JohnWallis01/TTL-GPU/CPLD-GPU Kicad Schematics/CPLD-GPU.html

# E:\Libraries\Documents\TTL-GPU\CPLD-GPU Kicad Schematics\CPLD-GPU.sch

23/11/2021 10:13:46

Eeschema (5.1.10)-1

Component Count:61

Ref | Qnty | Value | Part | Footprint | Description | Vendor
C1, C2 | 2 | 32p | Device:C | Capacitor_SMD:C_0805_2012Metric | Unpolarized capacitor
C3, C4, C5, C6, C7, C8, C9, C10, C11, C12, C13, C14 | 12 | 100n | Device:C | Capacitor_SMD:C_0805_2012Metric | Unpolarized capacitor
C15, C16, C17, C18, C19, C20, C21, C22, C23, C24, C25, C26 | 12 | 1u | Device:C | Capacitor_SMD:C_0805_2012Metric | Unpolarized capacitor
J1 | 1 | DB15_Female_HighDensity_MountingHoles | Connector:DB15_Female_HighDensity_MountingHoles | Connector_Dsub:DSUB-15_Female_Horizontal_P2.77x2.84mm_EdgePinOffset4.94mm_Housed_MountingHolesOffset7.48mm | 15-pin female D-SUB connector, High density (3 columns), Triple Row, Generic, VGA-connector, Mounting Hole
J2, J3 | 2 | Conn_01x02 | Connector_Generic:Conn_01x02 | Connector_PinHeader_2.54mm:PinHeader_1x02_P2.54mm_Vertical | Generic connector, single row, 01x02, script generated (kicad-library-utils/schlib/autogen/connector/)
J5 | 1 | Conn_01x05 | Connector_Generic:Conn_01x05 | Connector_PinHeader_2.54mm:PinHeader_1x05_P2.54mm_Vertical | Generic connector, single row, 01x05, script generated (kicad-library-utils/schlib/autogen/connector/)
J6 | 1 | Conn_01x16 | Connector_Generic:Conn_01x16 | Connector_PinHeader_2.54mm:PinHeader_1x16_P2.54mm_Vertical | Generic connector, single row, 01x16, script generated (kicad-library-utils/schlib/autogen/connector/)
R1 | 1 | 2.2M | Device:R | Resistor_SMD:R_0805_2012Metric | Resistor
R2 | 1 | 1K | Device:R | Resistor_SMD:R_0805_2012Metric | Resistor
R3, R4, R5, R21, R22 | 5 | 50K | Device:R | Resistor_SMD:R_0805_2012Metric | Resistor
R6, R7, R8, R9, R10, R11, R12, R13, R14, R15, R16, R17, R18, R19, R20 | 15 | 1.5K | Device:R | Resistor_SMD:R_0805_2012Metric | Resistor
U1 | 1 | SN74LVC1GX04DCKR | Gen3Parts:SN74LVC1GX04DCKR | Package_TO_SOT_SMD:SOT-363_SC-70-6_Handsoldering | Crystal Oscillator Driver
U2, U5 | 2 | AT25DN512C-XMHF-T | Gen3Parts:AT25DN512C-XMHF-T | Package_SO:SSOP-8_2.95x2.8mm_P0.65mm | NOR Flash 512K, 2.3V, 104Mhz Serial Flash
U3 | 1 | XC9572XL-10TQG100C | Gen3Parts:XC9572XL-10TQG100C | Package_QFP:TQFP-100_14x14mm_P0.5mm | XC9572XL-10TQG100C XC9572XL-10TQG100C, CPLD XC9500XL Flash 72 Cells, 72 I/O, 4 Labs, ISP, 3 3.6 V 100-Pin TQFP
U4 | 1 | CY62136EV30LL-45ZSXI | Gen3Parts:CY62136EV30LL-45ZSXI | Package_SO:TSOP-II-44_10.16x18.41mm_P0.8mm | CYPRESS SEMICONDUCTOR - CY62136EV30LL-45ZSXI - IC, SRAM, 2 Mbit, 128K x 16bit, 45 ns Access Time, Parallel, 2.2 V to 3.6 V supply, TSOP-II-44
U6, U7 | 2 | 74LS541 | 74xx:74LS541 | Package_SO:TSSOP-20_4.4x6.5mm_P0.65mm | 8-bit Buffer/Line Driver 3-state outputs
Y1 | 1 | Crystal | Device:Crystal | Crystal:Crystal_HC49-4H_Vertical | Two pin crystal
