JohnWallis01/TTL-GPU/MAX7000-GPU Kicad Schematics/MAX7000-GPU/MAX7000-GPU.html

# E:\Libraries\Documents\TTL-GPU\MAX7000-GPU Kicad Schematics\MAX7000-GPU\MAX7000-GPU.sch

17/04/2022 12:52:48

Eeschema (5.1.10)-1

Component Count:82

Ref | Qnty | Value | Part | Footprint | Description | Vendor
C1, C2, C3, C4, C5, C6, C7, C8, C9, C10, C11, C12, C13, C14, C15, C17, C21, C23, C25 | 19 | 100n | Device:C | Capacitor_SMD:C_0805_2012Metric | Unpolarized capacitor
C16, C20, C22 | 3 | 10n | Device:C | Capacitor_SMD:C_0805_2012Metric | Unpolarized capacitor
C18, C19 | 2 | 10p | Device:C | Capacitor_SMD:C_0805_2012Metric | Unpolarized capacitor
C24 | 1 | 330n | Device:C | Capacitor_SMD:C_0805_2012Metric | Unpolarized capacitor
D1, D2, D3, D4, D5, D6, D7, D8 | 8 | LED | Device:LED | LED_SMD:LED_0805_2012Metric | Light emitting diode
J1 | 1 | Mini-DIN-6 | Connector:Mini-DIN-6 | Custom_Footprints:Connector_Mini-DIN_Female_6Pin_2rows | 6-pin Mini-DIN connector
J2, J9 | 2 | Conn_01x04_Male | Connector:Conn_01x04_Male | Connector_PinSocket_2.54mm:PinSocket_1x04_P2.54mm_Vertical | Generic connector, single row, 01x04, script generated (kicad-library-utils/schlib/autogen/connector/)
J3 | 1 | Conn_01x05 | Connector_Generic:Conn_01x05 | Connector_PinSocket_2.54mm:PinSocket_1x05_P2.54mm_Vertical | Generic connector, single row, 01x05, script generated (kicad-library-utils/schlib/autogen/connector/)
J4 | 1 | Barrel_Jack | Connector:Barrel_Jack | Connector_BarrelJack:BarrelJack_Wuerth_6941xx301002 | DC Barrel Jack
J5 | 1 | DB15_Female_HighDensity_MountingHoles | Connector:DB15_Female_HighDensity_MountingHoles | Connector_Dsub:DSUB-15-HD_Female_Horizontal_P2.29x1.98mm_EdgePinOffset3.03mm_Housed_MountingHolesOffset4.94mm | 15-pin female D-SUB connector, High density (3 columns), Triple Row, Generic, VGA-connector, Mounting Hole
J6 | 1 | Conn_01x03_Male | Connector:Conn_01x03_Male | Connector_PinSocket_2.54mm:PinSocket_1x03_P2.54mm_Vertical | Generic connector, single row, 01x03, script generated (kicad-library-utils/schlib/autogen/connector/)
J7, J8 | 2 | Conn_01x16_Male | Connector:Conn_01x16_Male | Connector_PinSocket_2.54mm:PinSocket_1x16_P2.54mm_Vertical | Generic connector, single row, 01x16, script generated (kicad-library-utils/schlib/autogen/connector/)
J10 | 1 | Conn_02x05_Odd_Even | Connector_Generic:Conn_02x05_Odd_Even | Connector_PinHeader_2.54mm:PinHeader_2x05_P2.54mm_Vertical | Generic connector, double row, 02x05, odd/even pin numbering scheme (row 1 odd numbers, row 2 even numbers), script generated (kicad-library-utils/schlib/autogen/connector/)
R1, R3, R7, R11 | 4 | 1M | Device:R | Resistor_SMD:R_0805_2012Metric | Resistor
R2, R5, R6, R9, R10, R13, R14, R15, R16, R18, R19 | 11 | 1k | Device:R | Resistor_SMD:R_0805_2012Metric | Resistor
R4, R12, R17, R20, R21, R22, R23, R24, R25 | 9 | 330 | Device:R | Resistor_SMD:R_0805_2012Metric | Resistor
R8 | 1 | 50k | Device:R | Resistor_SMD:R_0805_2012Metric | Resistor
SW1, SW2, SW3 | 3 | SW_Push | MAX7000CPU-Gen2_5-rescue:SW_Push-Switch-MAX7000CPU-Gen2-rescue | Button_Switch_THT:SW_PUSH_6mm
U1 | 1 | EPM7128s | MAX7000CPU-Gen2_5-rescue:EPM7128slc84-15n-CPU_ics | Package_LCC:PLCC-84_THT-Socket
U2 | 1 | 74HC00 | 74xx:74HC00 | Package_DIP:DIP-14_W7.62mm | quad 2-input NAND gate
U3, U5, U8 | 3 | NE555 | Timer:NE555P | Package_DIP:DIP-8_W7.62mm | Precision Timers, 555 compatible, PDIP-8
U4 | 1 | AS6C1008 | MAX7000CPU-Gen2_5-rescue:AS6C1008-55PCN-CPU_ics | Package_DIP:DIP-32_W15.24mm
U6, U7, U9 | 3 | AT24C64 | GPU_Parts:AT24C64B-10PU-2.7 | Package_DIP:DIP-8_W7.62mm | Atmel AT24C64B-10PU-2.7 EEPROM Memory, 64kbit, 0.6us, 1.8 5.5 V 8-Pin PDIP
U10 | 1 | L7805 | Regulator_Linear:L7805 | Package_TO_SOT_THT:TO-220-3_Vertical | Positive 1.5A 35V Linear Regulator, Fixed Output 5V, TO-220/TO-263/TO-252
Y1 | 1 | Crystal | Device:Crystal | Crystal:Crystal_HC49-U_Vertical | Two pin crystal
