JohnWallis01/TTL-GPU/(list of files, drawings)

Other design files:
MAX7000-GPU Kicad Schematics/MAX7000-GPU/MAX7000-GPU.dsn
