JohnWallis01/TTL-GPU/CPLD-GPU Kicad Schematics/CPLD-GPU.kicad_pcb

## KiCad design CPLD-GPU Kicad Schematics/CPLD-GPU.kicad_pcb (2022-04-17)

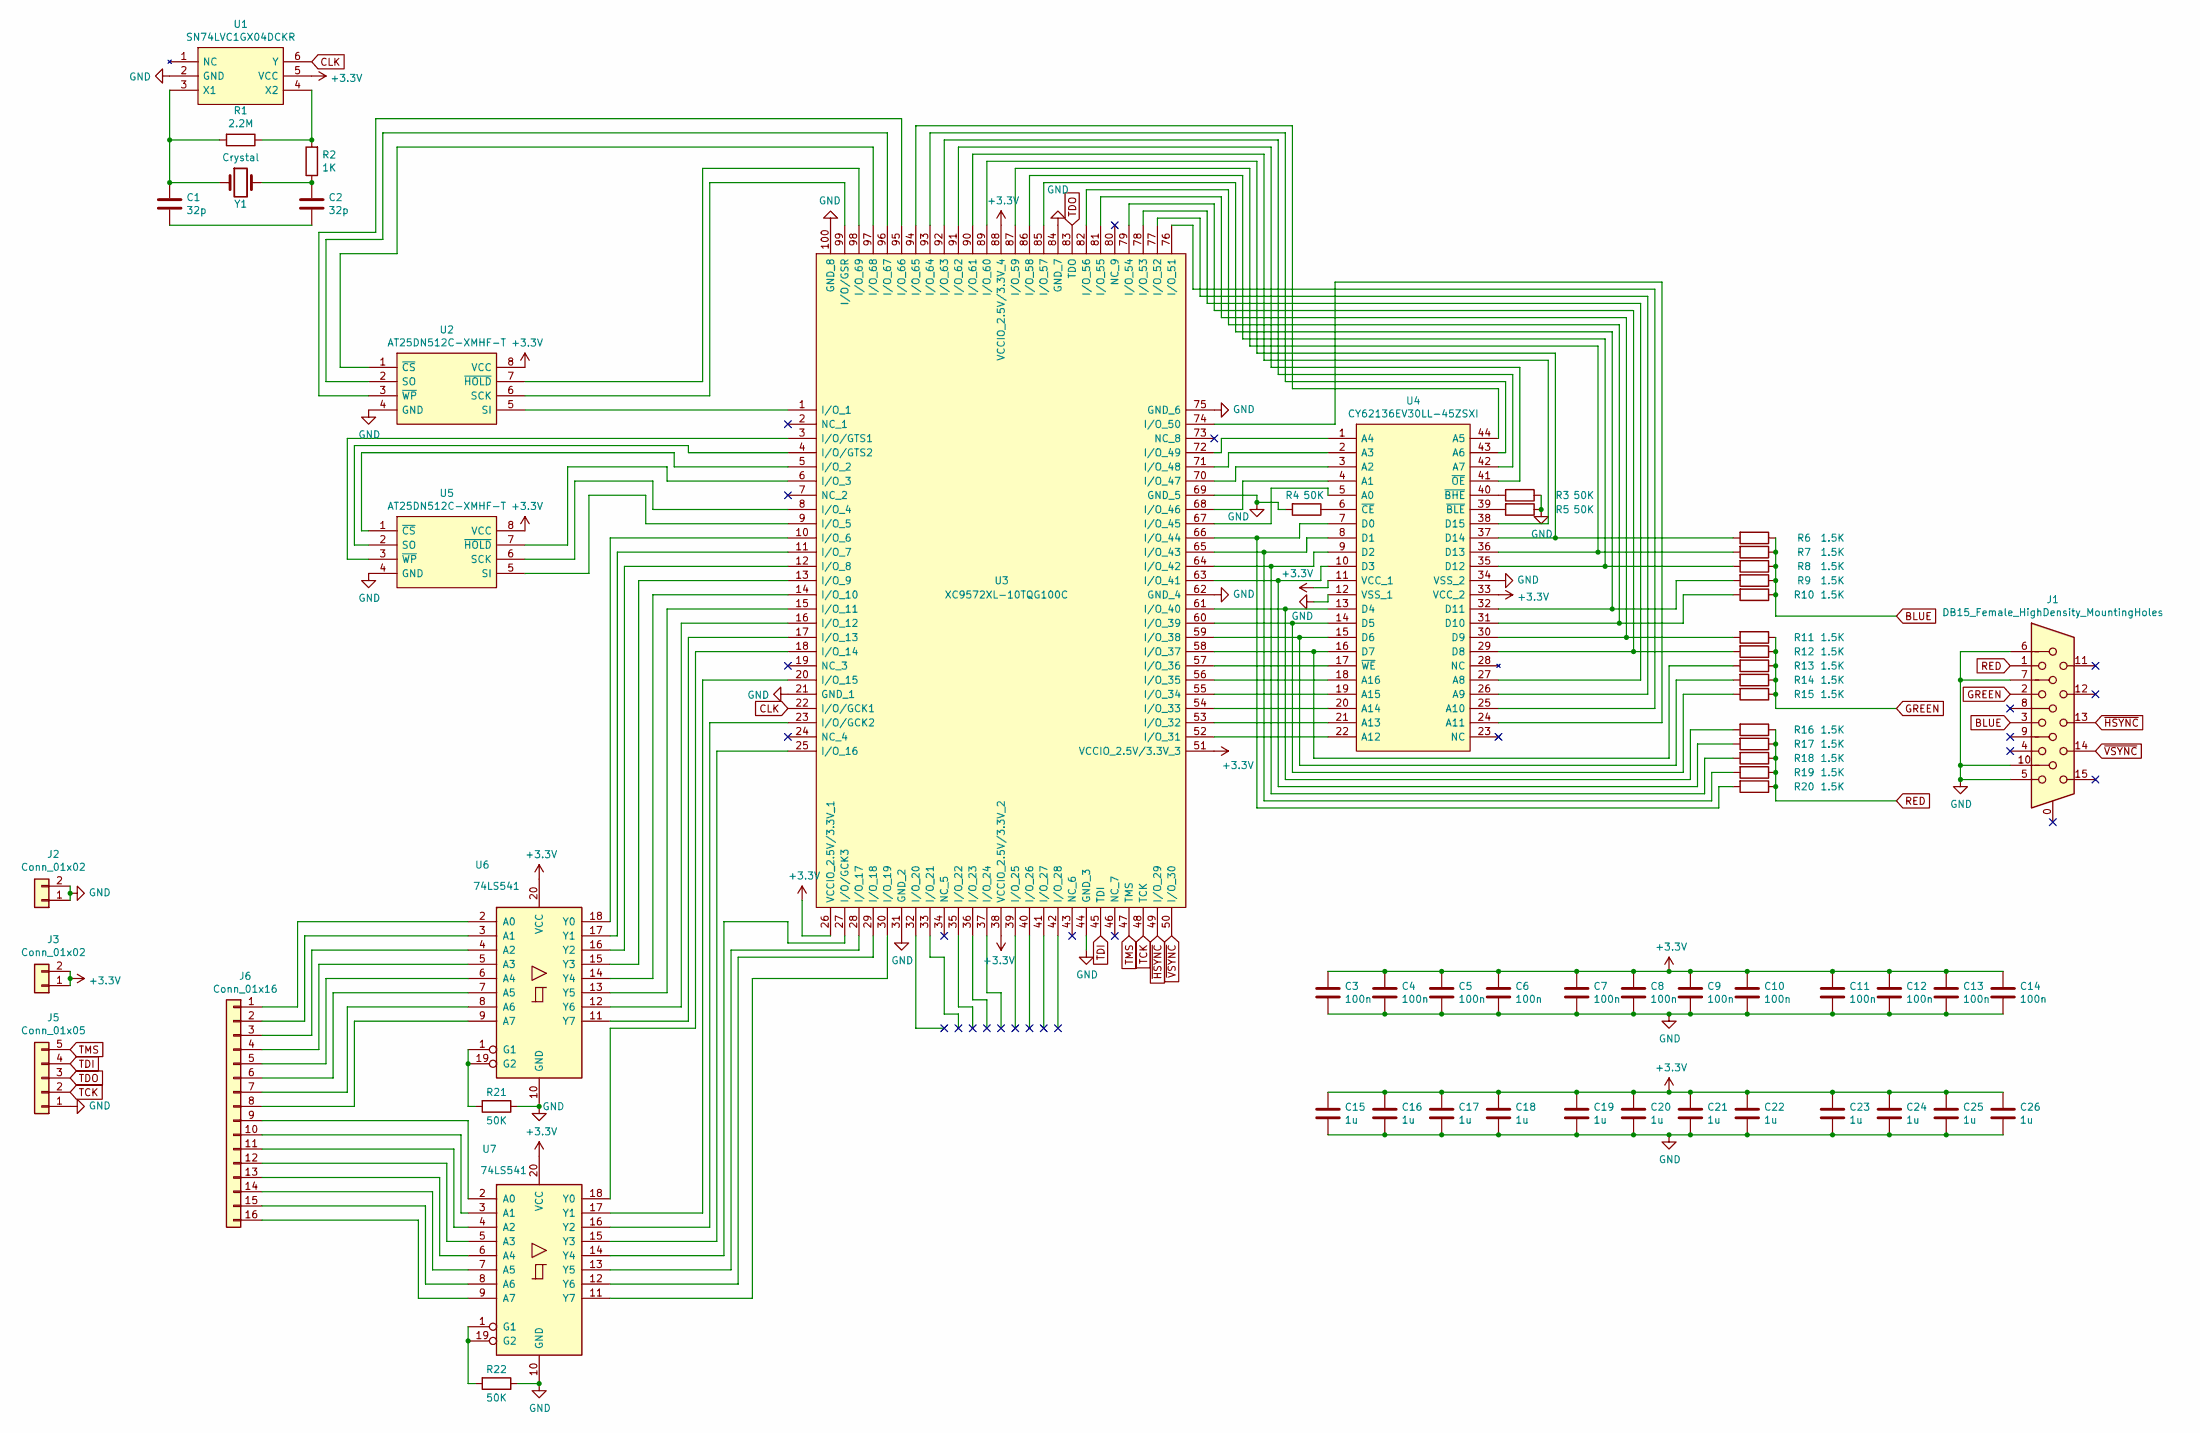
[picture p13: schematic CPLD-GPU.sch]

Parts:
C1, C2: 32p; C_0805_2012Metric
C3, C4, C5, C6, C7, C8, C9, C10, C11, C12, C13, C14: 100n; C_0805_2012Metric
C15, C16, C17, C18, C19, C20, C21, C22, C23, C24, C25, C26: 1u; C_0805_2012Metric
J1: DB15_Female_HighDensity_MountingHoles; DSUB-15_Female_Horizontal_P2.77x2.84mm_EdgePinOffset4.94mm_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
J2, J3: Conn_01x02; PinHeader_1x02_P2.54mm_Vertical
J5: Conn_01x05; PinHeader_1x05_P2.54mm_Vertical
J6: Conn_01x16; PinHeader_1x16_P2.54mm_Vertical
R1: 2.2M; R_0805_2012Metric
R2: 1K; R_0805_2012Metric
R3, R4, R5, R21, R22: 50K; R_0805_2012Metric
R6, R7, R8, R9, R10, R11, R12, R13, R14, R15, R16, R17, R18, R19, R20: 1.5K; R_0805_2012Metric
U1: SN74LVC1GX04DCKR; SOT-363_SC-70-6_Handsoldering; Mouser Part Number 595-SN74LVC1GX04DCKR
U2, U5: AT25DN512C-XMHF-T; SSOP-8_2.95x2.8mm_P0.65mm; Manufacturer_Part_Number AT25DN512C-XMHF-T
U3: XC9572XL-10TQG100C; TQFP-100_14x14mm_P0.5mm; Mouser Part Number 217-9572XL-10TQG100C
U4: CY62136EV30LL-45ZSXI; TSOP-II-44_10.16x18.41mm_P0.8mm; Manufacturer_Part_Number CY62136EV30LL-45ZSXI
U6, U7: 74LS541; TSSOP-20_4.4x6.5mm_P0.65mm
Y1: Crystal; Crystal_HC49-4H_Vertical

Connections:
+3V3: C3.1, C4.1, C5.1, C6.1, C7.1, C8.1, C9.1, C10.1, C11.1, C12.1, C13.1, C14.1, C15.1, C16.1, C17.1, C18.1, C19.1, C20.1, C21.1, C22.1, C23.1, C24.1, C25.1, C26.1, J3.1, J3.2, U1.5 (VCC), U2.8 (VCC), U3.26 (VCCIO_2.5V/3.3V_1), U3.38 (VCCIO_2.5V/3.3V_2), U3.51 (VCCIO_2.5V/3.3V_3), U3.88 (VCCIO_2.5V/3.3V_4), U4.11 (VCC_1), U4.33 (VCC_2), U5.8 (VCC), U6.20 (VCC), U7.20 (VCC)
BLUE: J1.3, R6.1, R7.1, R8.1, R9.1, R10.1
CLK: U1.6 (Y), U3.22 (I/O/GCK1)
GND: C3.2, C4.2, C5.2, C6.2, C7.2, C8.2, C9.2, C10.2, C11.2, C12.2, C13.2, C14.2, C15.2, C16.2, C17.2, C18.2, C19.2, C20.2, C21.2, C22.2, C23.2, C24.2, C25.2, C26.2, J1.5, J1.6, J1.7, J1.10, J2.1, J2.2, J5.1, R3.1, R4.2, R5.1, R21.1, R22.1, U1.2 (GND), U2.4 (GND), U3.21 (GND_1), U3.31 (GND_2), U3.44 (GND_3), U3.62 (GND_4), U3.69 (GND_5), U3.75 (GND_6), U3.84 (GND_7), U3.100 (GND_8), U4.12 (VSS_1), U4.34 (VSS_2), U5.4 (GND), U6.10 (GND), U7.10 (GND)
GREEN: J1.2, R11.1, R12.1, R13.1, R14.1, R15.1
unnamed: C1.1, R1.2, U1.3 (X1), Y1.1
unnamed: C1.2, C2.2
unnamed: C2.1, R2.1, Y1.2
unnamed: J6.1, U6.2 (A0)
unnamed: J6.2, U6.3 (A1)
unnamed: J6.3, U6.4 (A2)
unnamed: J6.4, U6.5 (A3)
unnamed: J6.5, U6.6 (A4)
unnamed: J6.6, U6.7 (A5)
unnamed: J6.7, U6.8 (A6)
unnamed: J6.8, U6.9 (A7)
unnamed: J6.9, U7.2 (A0)
unnamed: J6.10, U7.3 (A1)
unnamed: J6.11, U7.4 (A2)
unnamed: J6.12, U7.5 (A3)
unnamed: J6.13, U7.6 (A4)
unnamed: J6.14, U7.7 (A5)
unnamed: J6.15, U7.8 (A6)
unnamed: J6.16, U7.9 (A7)
unnamed: R1.1, R2.2, U1.4 (X2)
unnamed: R3.2, U4.40 (~BHE)
unnamed: R4.1, U4.6 (~CE)
unnamed: R5.2, U4.39 (~BLE)
unnamed: R6.2, U3.89 (I/O_60), U4.37 (D14)
unnamed: R7.2, U3.87 (I/O_59), U4.36 (D13)
unnamed: R8.2, U3.86 (I/O_58), U4.35 (D12)
unnamed: R9.2, U3.85 (I/O_57), U4.32 (D11)
unnamed: R10.2, U3.82 (I/O_56), U4.31 (D10)
unnamed: R11.2, U3.81 (I/O_55), U4.30 (D9)
unnamed: R12.2, U3.79 (I/O_54), U4.29 (D8)
unnamed: R13.2, U3.58 (I/O_37), U4.16 (D7)
unnamed: R14.2, U3.59 (I/O_38), U4.15 (D6)
unnamed: R15.2, U3.60 (I/O_39), U4.14 (D5)
unnamed: R16.2, U3.61 (I/O_40), U4.13 (D4)
unnamed: R17.2, U3.63 (I/O_41), U4.10 (D3)
unnamed: R18.2, U3.64 (I/O_42), U4.9 (D2)
unnamed: R19.2, U3.65 (I/O_43), U4.8 (D1)
unnamed: R20.2, U3.66 (I/O_44), U4.7 (D0)
unnamed: R21.2, U6.1 (G1), U6.19 (G2)
unnamed: R22.2, U7.1 (G1), U7.19 (G2)
unnamed: U2.1 (~CS), U3.97 (I/O_68)
unnamed: U2.2 (SO), U3.96 (I/O_67)
unnamed: U2.3 (~WP), U3.95 (I/O_66)
unnamed: U2.5 (SI), U3.1 (I/O_1)
unnamed: U2.6 (SCK), U3.99 (I/O/GSR)
unnamed: U2.7 (~HOLD), U3.98 (I/O_69)
unnamed: U3.3 (I/O/GTS1), U5.3 (~WP)
unnamed: U3.4 (I/O/GTS2), U5.2 (SO)
unnamed: U3.5 (I/O_2), U5.1 (~CS)
unnamed: U3.6 (I/O_3), U5.7 (~HOLD)
unnamed: U3.8 (I/O_4), U5.6 (SCK)
unnamed: U3.9 (I/O_5), U5.5 (SI)
unnamed: U3.10 (I/O_6), U6.18 (Y0)
unnamed: U3.11 (I/O_7), U6.17 (Y1)
unnamed: U3.12 (I/O_8), U6.16 (Y2)
unnamed: U3.13 (I/O_9), U6.15 (Y3)
unnamed: U3.14 (I/O_10), U6.14 (Y4)
unnamed: U3.15 (I/O_11), U6.13 (Y5)
unnamed: U3.16 (I/O_12), U6.12 (Y6)
unnamed: U3.17 (I/O_13), U6.11 (Y7)
unnamed: U3.18 (I/O_14), U7.18 (Y0)
unnamed: U3.20 (I/O_15), U7.17 (Y1)
unnamed: U3.23 (I/O/GCK2), U7.16 (Y2)
unnamed: U3.25 (I/O_16), U7.15 (Y3)
unnamed: U3.27 (I/O/GCK3), U7.14 (Y4)
unnamed: U3.28 (I/O_17), U7.13 (Y5)
unnamed: U3.29 (I/O_18), U7.12 (Y6)
unnamed: U3.30 (I/O_19), U7.11 (Y7)
unnamed: U3.52 (I/O_31), U4.22 (A12)
unnamed: U3.53 (I/O_32), U4.21 (A13)
unnamed: U3.54 (I/O_33), U4.20 (A14)
unnamed: U3.55 (I/O_34), U4.19 (A15)
unnamed: U3.56 (I/O_35), U4.18 (A16)
unnamed: U3.57 (I/O_36), U4.17 (~WE)
unnamed: U3.67 (I/O_45), U4.5 (A0)
unnamed: U3.68 (I/O_46), U4.4 (A1)
unnamed: U3.70 (I/O_47), U4.3 (A2)
unnamed: U3.71 (I/O_48), U4.2 (A3)
unnamed: U3.72 (I/O_49), U4.1 (A4)
unnamed: U3.74 (I/O_50), U4.24 (A11)
unnamed: U3.76 (I/O_51), U4.25 (A10)
unnamed: U3.77 (I/O_52), U4.26 (A9)
unnamed: U3.78 (I/O_53), U4.27 (A8)
unnamed: U3.90 (I/O_61), U4.38 (D15)
unnamed: U3.91 (I/O_62), U4.41 (~OE)
unnamed: U3.92 (I/O_63), U4.42 (A7)
unnamed: U3.93 (I/O_64), U4.43 (A6)
unnamed: U3.94 (I/O_65), U4.44 (A5)
RED: J1.1, R16.1, R17.1, R18.1, R19.1, R20.1
TCK: J5.2, U3.48 (TCK)
TDI: J5.4, U3.45 (TDI)
TDO: J5.3, U3.83 (TDO)
TMS: J5.5, U3.47 (TMS)
~HSYNC: J1.13, U3.49 (I/O_29)
~VSYNC: J1.14, U3.50 (I/O_30)

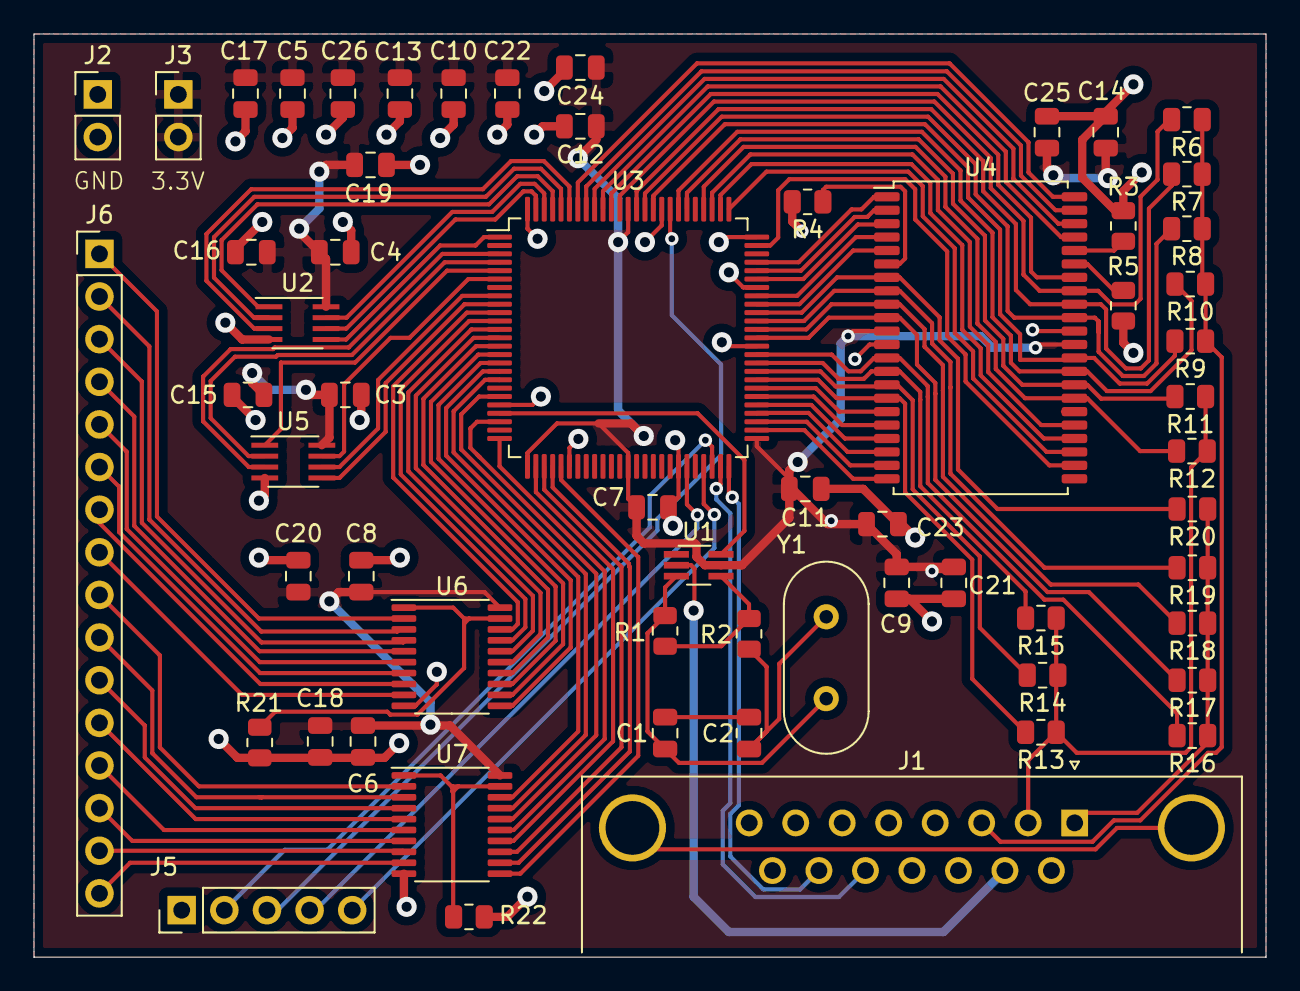
[picture p14: board CPLD-GPU.kicad_pcb from above]

Board: 2 copper layers, 73.4 x 55.0 mm, 61 parts (0 on the bottom side), 100 nets.
