JohnWallis01/TTL-GPU/MAX7000-GPU Kicad Schematics/MAX7000-GPU/MAX7000-GPU.kicad_pcb

## KiCad design MAX7000-GPU Kicad Schematics/MAX7000-GPU/MAX7000-GPU.kicad_pcb (2022-04-17)

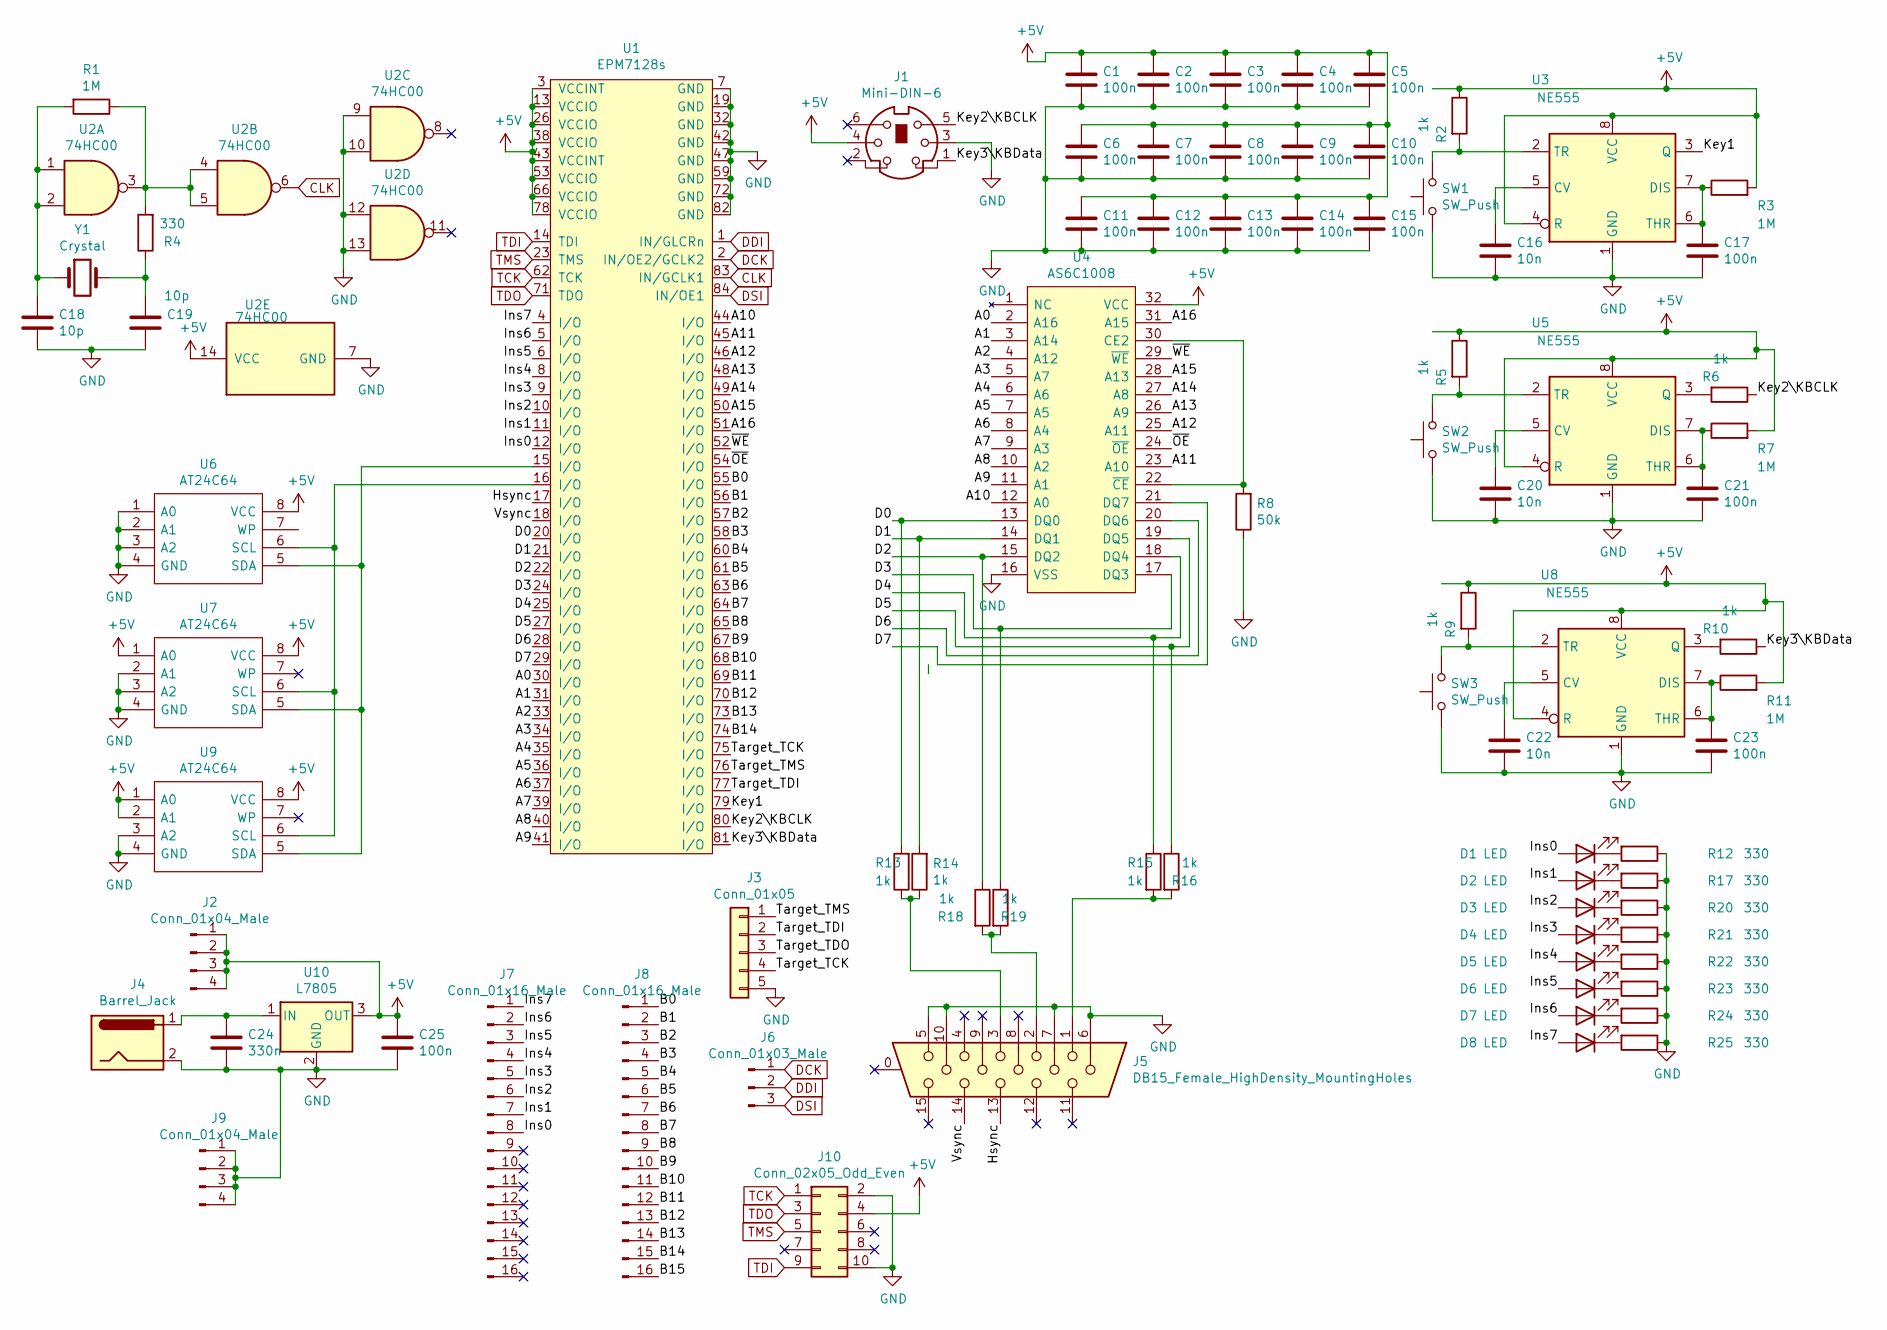
[picture p15: schematic MAX7000-GPU.sch]

Parts:
C1, C2, C3, C4, C5, C6, C7, C8, C9, C10, C11, C12, C13, C14, C15, C17, C21, C23, C25: 100n; C_0805_2012Metric
C16, C20, C22: 10n; C_0805_2012Metric
C18, C19: 10p; C_0805_2012Metric
C24: 330n; C_0805_2012Metric
D1, D2, D3, D4, D5, D6, D7, D8: LED; LED_0805_2012Metric
J1: Mini-DIN-6; Connector_Mini-DIN_Female_6Pin_2rows
J2, J9: Conn_01x04_Male; PinSocket_1x04_P2.54mm_Vertical
J3: Conn_01x05; PinSocket_1x05_P2.54mm_Vertical
J4: Barrel_Jack; BarrelJack_Wuerth_6941xx301002
J5: DB15_Female_HighDensity_MountingHoles; DSUB-15-HD_Female_Horizontal_P2.29x1.98mm_EdgePinOffset3.03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
J6: Conn_01x03_Male; PinSocket_1x03_P2.54mm_Vertical
J7, J8: Conn_01x16_Male; PinSocket_1x16_P2.54mm_Vertical
J10: Conn_02x05_Odd_Even; PinHeader_2x05_P2.54mm_Vertical
R1, R3, R7, R11: 1M; R_0805_2012Metric
R2, R5, R6, R9, R10, R13, R14, R15, R16, R18, R19: 1k; R_0805_2012Metric
R4, R12, R17, R20, R21, R22, R23, R24, R25: 330; R_0805_2012Metric
R8: 50k; R_0805_2012Metric
SW1, SW2, SW3: SW_Push; SW_PUSH_6mm
U1: EPM7128s; PLCC-84_THT-Socket
U2: 74HC00; DIP-14_W7.62mm
U3, U5, U8: NE555; DIP-8_W7.62mm
U4: AS6C1008; DIP-32_W15.24mm; Mouser Part Number 913-AS6C1008-55PCN
U6, U7, U9: AT24C64; DIP-8_W7.62mm; Manufacturer_Part_Number AT24C64B-10PU-2.7
U10: L7805; TO-220-3_Vertical
Y1: Crystal; Crystal_HC49-U_Vertical

Connections:
+5V: C1.1, C2.1, C3.1, C4.1, C5.1, C6.1, C7.1, C8.1, C9.1, C10.1, C11.1, C12.1, C13.1, C14.1, C15.1, C25.1, J1.4, J2.1, J2.2, J2.3, J2.4, J10.4, R2.1, R3.2, R5.1, R7.2, R9.1, R11.2, U1.3 (VCCINT), U1.13 (VCCIO), U1.26 (VCCIO), U1.38 (VCCIO), U1.43 (VCCINT), U1.53 (VCCIO), U1.66 (VCCIO), U1.78 (VCCIO), U2.14 (VCC), U3.4 (R), U3.8 (VCC), U4.32 (VCC), U5.4 (R), U5.8 (VCC), U6.8 (VCC), U7.1 (A0), U7.8 (VCC), U8.4 (R), U8.8 (VCC), U9.1 (A0), U9.2 (A1), U9.8 (VCC), U10.3 (OUT)
/A0: U1.30 (I/O), U4.2 (A16)
/A1: U1.31 (I/O), U4.3 (A14)
/A2: U1.33 (I/O), U4.4 (A12)
/A3: U1.34 (I/O), U4.5 (A7)
/A4: U1.35 (I/O), U4.6 (A6)
/A5: U1.36 (I/O), U4.7 (A5)
/A6: U1.37 (I/O), U4.8 (A4)
/A7: U1.39 (I/O), U4.9 (A3)
/A8: U1.40 (I/O), U4.10 (A2)
/A9: U1.41 (I/O), U4.11 (A1)
/A10: U1.44 (I/O), U4.12 (A0)
/A11: U1.45 (I/O), U4.23 (A10)
/A12: U1.46 (I/O), U4.25 (A11)
/A13: U1.48 (I/O), U4.26 (A9)
/A14: U1.49 (I/O), U4.27 (A8)
/A15: U1.50 (I/O), U4.28 (A13)
/A16: U1.51 (I/O), U4.31 (A15)
/B0: J8.1, U1.55 (I/O)
/B1: J8.2, U1.56 (I/O)
/B2: J8.3, U1.57 (I/O)
/B3: J8.4, U1.58 (I/O)
/B4: J8.5, U1.60 (I/O)
/B5: J8.6, U1.61 (I/O)
/B6: J8.7, U1.63 (I/O)
/B7: J8.8, U1.64 (I/O)
/B8: J8.9, U1.65 (I/O)
/B9: J8.10, U1.67 (I/O)
/B10: J8.11, U1.68 (I/O)
/B11: J8.12, U1.69 (I/O)
/B12: J8.13, U1.70 (I/O)
/B13: J8.14, U1.73 (I/O)
/B14: J8.15, U1.74 (I/O)
/D0: R13.2, U1.20 (I/O), U4.13 (DQ0)
/D1: R14.2, U1.21 (I/O), U4.14 (DQ1)
/D2: R18.1, U1.22 (I/O), U4.15 (DQ2)
/D3: R19.1, U1.24 (I/O), U4.17 (DQ3)
/D4: R15.1, U1.25 (I/O), U4.18 (DQ4)
/D5: R16.1, U1.27 (I/O), U4.19 (DQ5)
/D6: U1.28 (I/O), U4.20 (DQ6)
/D7: U1.29 (I/O), U4.21 (DQ7)
/Hsync: J5.13, U1.17 (I/O)
/Ins0: D1.2 (A), J7.8, U1.12 (I/O)
/Ins1: D2.2 (A), J7.7, U1.11 (I/O)
/Ins2: D3.2 (A), J7.6, U1.10 (I/O)
/Ins3: D4.2 (A), J7.5, U1.9 (I/O)
/Ins4: D5.2 (A), J7.4, U1.8 (I/O)
/Ins5: D6.2 (A), J7.3, U1.6 (I/O)
/Ins6: D7.2 (A), J7.2, U1.5 (I/O)
/Ins7: D8.2 (A), J7.1, U1.4 (I/O)
/Key1: U1.79 (I/O), U3.3 (Q)
/Key2\KBCLK: J1.5, R6.1, U1.80 (I/O)
/Key3\KBData: J1.1, R10.1, U1.81 (I/O)
/Target_TCK: J3.4, U1.75 (I/O)
/Target_TDI: J3.2, U1.77 (I/O)
/Target_TMS: J3.1, U1.76 (I/O)
/Vsync: J5.14, U1.18 (I/O)
/~OE: U1.54 (I/O), U4.24 (~OE)
/~WE: U1.52 (I/O), U4.29 (~WE)
CLK: U1.83 (IN/GCLK1), U2.6
DCK: J6.1, U1.2 (IN/OE2/GCLK2)
DDI: J6.2, U1.1 (IN/GLCRn)
DSI: J6.3, U1.84 (IN/OE1)
GND: C1.2, C2.2, C3.2, C4.2, C5.2, C6.2, C7.2, C8.2, C9.2, C10.2, C11.2, C12.2, C13.2, C14.2, C15.2, C16.2, C17.2, C18.2, C19.2, C20.2, C21.2, C22.2, C23.2, C24.2, C25.2, J1.3, J3.5, J4.2, J5.5, J5.6, J5.7, J5.10, J9.1, J9.2, J9.3, J9.4, J10.2, J10.10, R8.1, R12.1, R17.1, R20.1, R21.1, R22.1, R23.1, R24.1, R25.1, SW1.1, SW2.1, SW3.1, U1.7 (GND), U1.19 (GND), U1.32 (GND), U1.42 (GND), U1.47 (GND), U1.59 (GND), U1.72 (GND), U1.82 (GND), U2.7 (GND), U2.9, U2.10, U2.12, U2.13, U3.1 (GND), U4.16 (VSS), U5.1 (GND), U6.1 (A0), U6.2 (A1), U6.3 (A2), U6.4 (GND), U7.2 (A1), U7.3 (A2), U7.4 (GND), U8.1 (GND), U9.3 (A2), U9.4 (GND), U10.2 (GND)
unnamed: C16.1, U3.5 (CV)
unnamed: C17.1, R3.1, U3.6 (THR), U3.7 (DIS)
unnamed: C18.1, R1.2, U2.1, U2.2, Y1.1
unnamed: C19.1, R4.1, Y1.2
unnamed: C20.1, U5.5 (CV)
unnamed: C21.1, R7.1, U5.6 (THR), U5.7 (DIS)
unnamed: C22.1, U8.5 (CV)
unnamed: C23.1, R11.1, U8.6 (THR), U8.7 (DIS)
unnamed: C24.1, J4.1, U10.1 (IN)
unnamed: D1.1 (K), R12.2
unnamed: D2.1 (K), R17.2
unnamed: D3.1 (K), R20.2
unnamed: D4.1 (K), R21.2
unnamed: D5.1 (K), R22.2
unnamed: D6.1 (K), R23.2
unnamed: D7.1 (K), R24.2
unnamed: D8.1 (K), R25.2
unnamed: J5.1, R15.2, R16.2
unnamed: J5.2, R18.2, R19.2
unnamed: J5.3, R13.1, R14.1
unnamed: R1.1, R4.2, U2.3, U2.4, U2.5
unnamed: R2.2, SW1.2, U3.2 (TR)
unnamed: R5.2, SW2.2, U5.2 (TR)
unnamed: R6.2, U5.3 (Q)
unnamed: R8.2, U4.22 (~CE), U4.30 (CE2)
unnamed: R9.2, SW3.2, U8.2 (TR)
unnamed: R10.2, U8.3 (Q)
unnamed: U1.15 (I/O), U6.5 (SDA), U7.5 (SDA), U9.5 (SDA)
unnamed: U1.16 (I/O), U6.6 (SCL), U7.6 (SCL), U9.6 (SCL)
TCK: J10.1, U1.62 (TCK)
TDI: J10.9, U1.14 (TDI)
TDO: J10.3, U1.71 (TDO)
TMS: J10.5, U1.23 (TMS)

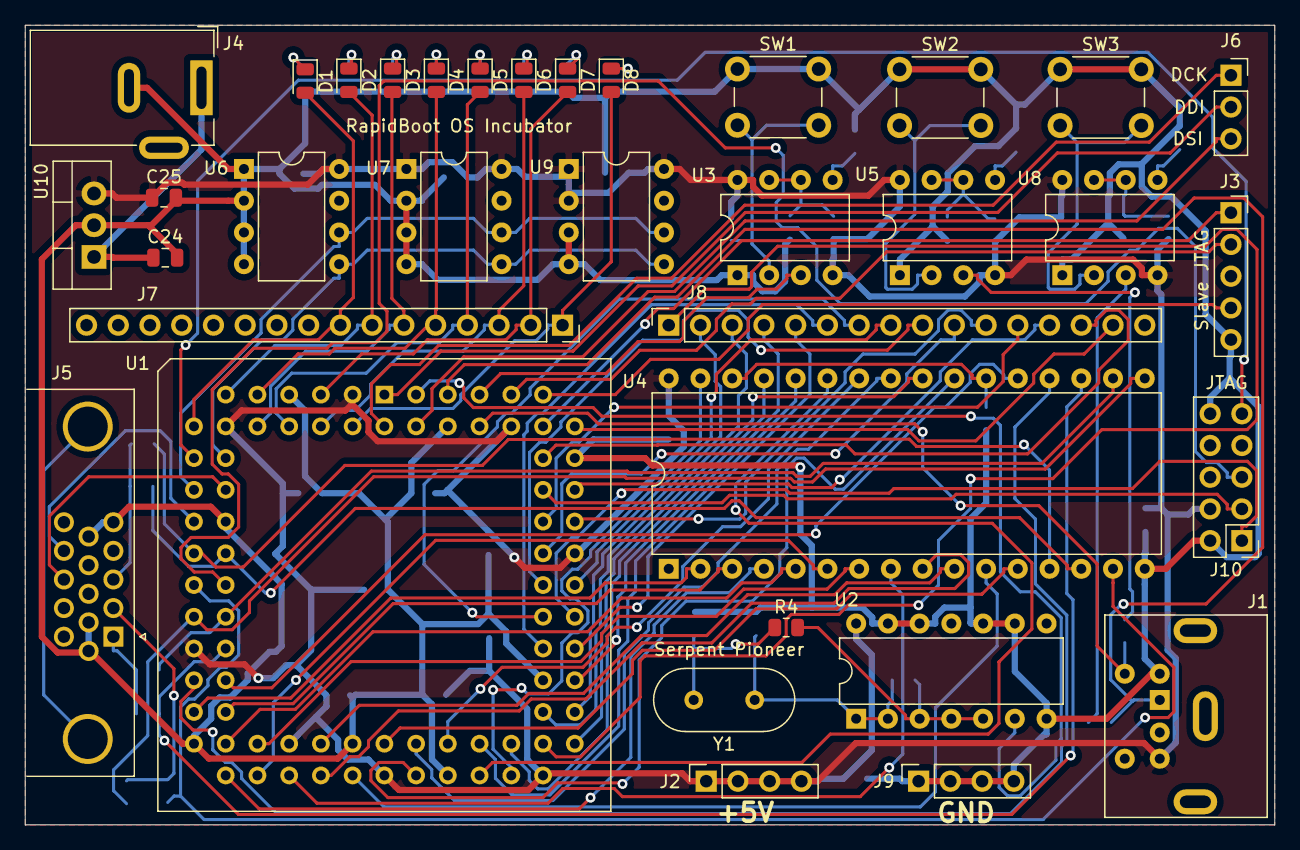
[picture p16: board MAX7000-GPU.kicad_pcb from above]

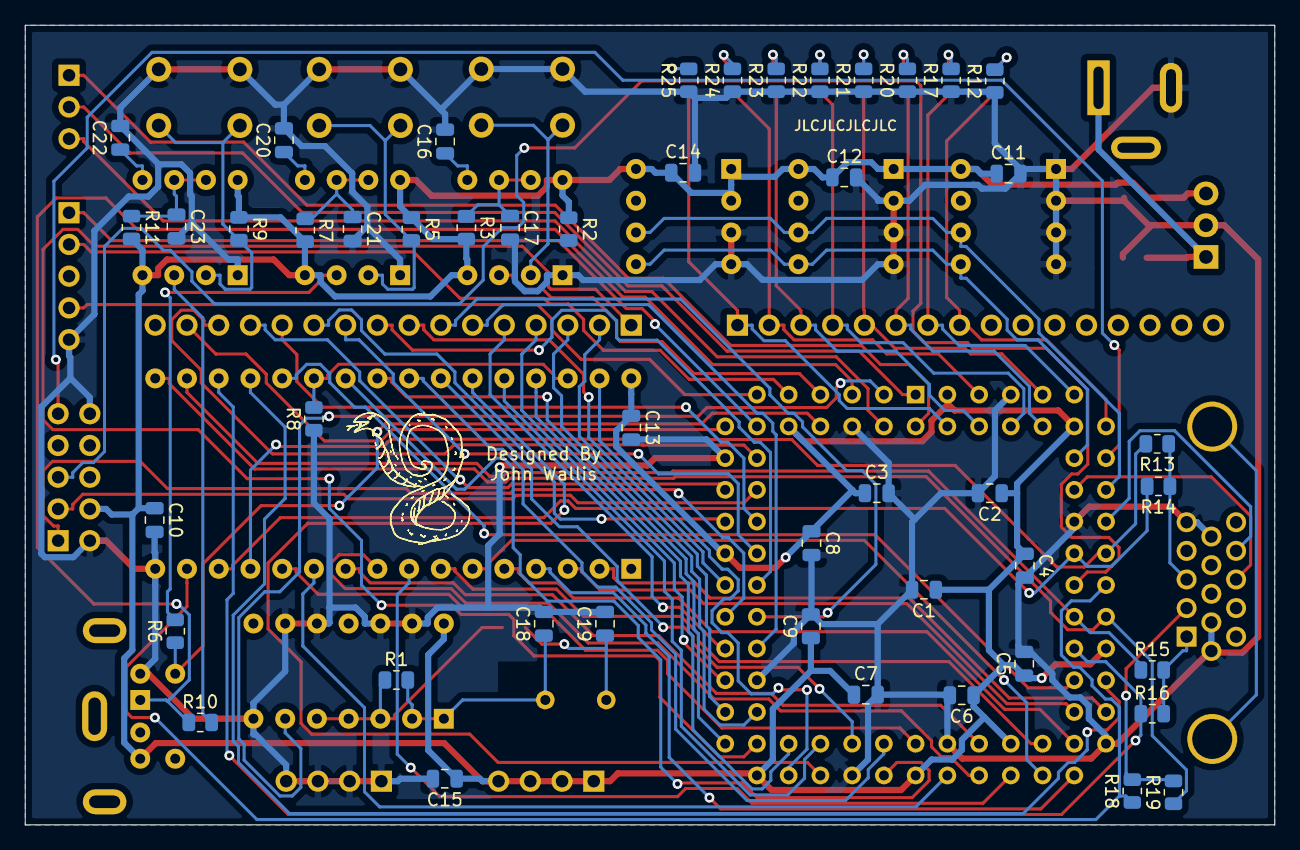
[picture p17: board MAX7000-GPU.kicad_pcb from below]

Board: 2 copper layers, 100.0 x 64.0 mm, 82 parts (47 on the bottom side), 97 nets.
