JohnWallis01/TTL-GPU/CPLD-GPU-Xilinx-ISE/CPLD-GPU/Main.vhdl

----------------------------------------------------------------------------------
-- Company: 
-- Engineer: 
-- 
-- Create Date:    12:23:54 11/24/2021 
-- Design Name: 
-- Module Name:    Main - Behavioral 
-- Project Name: 
-- Target Devices: 
-- Tool versions: 
-- Description: 
--
-- Dependencies: 
--
-- Revision: 
-- Revision 0.01 - File Created
-- Additional Comments: 
--
----------------------------------------------------------------------------------
library IEEE;
use IEEE.STD_LOGIC_1164.ALL;

-- Uncomment the following library declaration if using
-- arithmetic functions with Signed or Unsigned values
--use IEEE.NUMERIC_STD.ALL;

-- Uncomment the following library declaration if instantiating
-- any Xilinx primitives in this code.
--library UNISIM;
--use UNISIM.VComponents.all;

entity Main is
    Port ( CLK : in  STD_LOGIC;
           TEST : out  STD_LOGIC);
end Main;

architecture Behavioral of Main is

begin

TEST <= CLK;

end Behavioral;
