JohnWallis01/TTL-GPU/(commit log)

2022-04-17 Inital Commit
    [ASCIIROM.sch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]
2022-04-17 Bom Updates
